akih-san/FUZIX-for-MEZ68K8_RAM-Rev2.1/README.MD

# MEZ68K8_RAM Rev2.1 for FUZIX 0.5

MEZ68K8_RAM Rev2.1は[EMUZ80](https://vintagechips.wordpress.com/2022/03/05/emuz80_reference/)ボード上で動く68008メザニンボードです。

（MEZ68K8_RAM Rev2.1メザニンボード）
<br>

EMUZ80はMicrochip社のPIC18F47Q43/83/84を使用して、Z80を制御するシングルボードコンピュータ
です。また、Z80の代わりにメザニンボードを装着することで、レガシーCPU（6502や、8088、V20、他）
を動かすことが出来ます。<br>
UART, SPI, I2C等の制御をPICで行い、レガシーCPUの外部I/Oとして機能を提供します。
SDカードはSPIを通して実装されています。<br>
PICから、レガシーCPUのメモリ空間にアクセスすることで、レガシーPCのプログラムをロードする
ことが出来るため、ROMは必要なくSRAMでプログラムを動作させることが出来ます。

（EMUZ80、MEZ68K8_RAM、RTCモジュール、SDカードモジュール）
<br>

（動作中のMEZ68K8_RAM Rev2.1）
<br>

MEZ68K8_RAM Rev2.1の[FUZIX](https://www.fuzix.org/)は、platform-[pico68k](https://hackaday.io/project/179200-68000-minimal-homebrew-computer)をベースにポーティングを行いました。

リアルタイムクロックは、platform-[68knano](https://github.com/74hc595/68k-nano)のds3234デバイスの実装を参考にしています。
# FUZIX起動画面
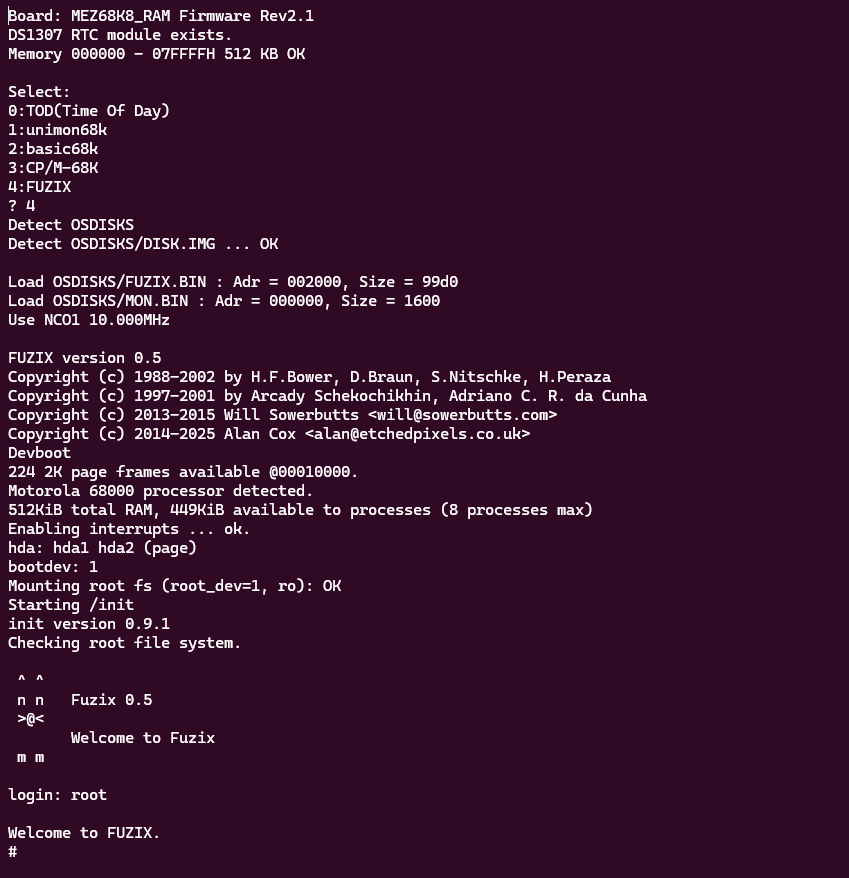
[picture p1: photo/FUZIX起動画面.png]
<br>

MEZ68K8_RAM Rev2.1では、FUZIX以外に、CP/M-68Kや68000用の[Universal Monitor](https://electrelic.com/electrelic/node/1317)をサポートしていますが、詳細については、[MEZ68K8_RAM(Rev1.3)](https://github.com/akih-san/MEZ68K8_RAM)を参照してください。

# [MEZ68K8_RAM(Rev1.3)](https://github.com/akih-san/MEZ68K8_RAM)からの追加変更点

１．IRQ, NMI割り込みのサポート<br>
２．RTC(DS1307)のサポート<br>
３．グルー・ロジック

## １．IRQ, NMI割り込みのサポート
Rev1.3では割り込みなく、最小限の機能を実現していました。Rev2.1では、オートベクターによるレベル５(IRQ)とレベル７(NMI)の割り込みをサポートします。<br>
10msインターバルのＩＲＱ割り込みを発生させています。UARTによるキー入力は、この割り込みでCPUに取り込まれ、バッファリングされます。<br>
CTRL-Qを2回連続して入力することで、NMI割り込みが発生します。FUZIX動作時には、NMI割り込みでモニタ（Universal Monitor）が起動します。<br>
ただし、CP/M-68KはIRQ、NMI割り込みを使っていません。（Rev1.3相当のCP/M-68K）<br>
その他のプログラムではNMI割り込みの表示が出ますが、何もしないで元のプログラムに復帰します。<br>
<br>
## ２．RTC(DS1307)のサポート
I2Cを実装し、DS1307を使ったTiny RTC moduleをサポートします。<br>
Tiny RTC moduleはArduinoで使用可能で、[AliExpress](https://ja.aliexpress.com/?spm=a2g0o.home.logo.1.2fc55c72FX1lyE)から入手
することができます。また、安価な互換品が出回っています。テストでは互換品を使いましたが、特に問題なく使用できました。
SQピン端子は未使用です。SCL、SDA、VCC、GNDの４ピンを使用しています。

(tiny_rtc_modules)<br>
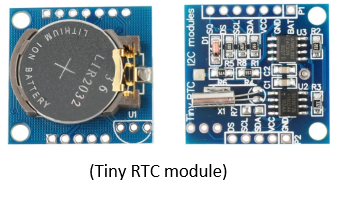
[picture p2: photo/tiny_rtc_modules.png]


(tiny_rtc_modules互換品.png)<br>
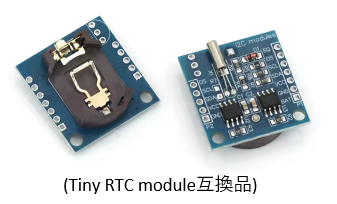
[picture p3: photo/tiny_rtc_modules互換品.png]
<br>

<br>
日時の設定は、ファームウェア起動時のセレクトリスト0番（TOD）で指定します。<br>
RTC(DS1307)モジュールが接続されていない場合、PICのtimer0の10msタイマーを用いて、日時をカウントします。その場合、電源OFFで日時が2025/06/01 00:00:00にリセットされます。<br>
<br>

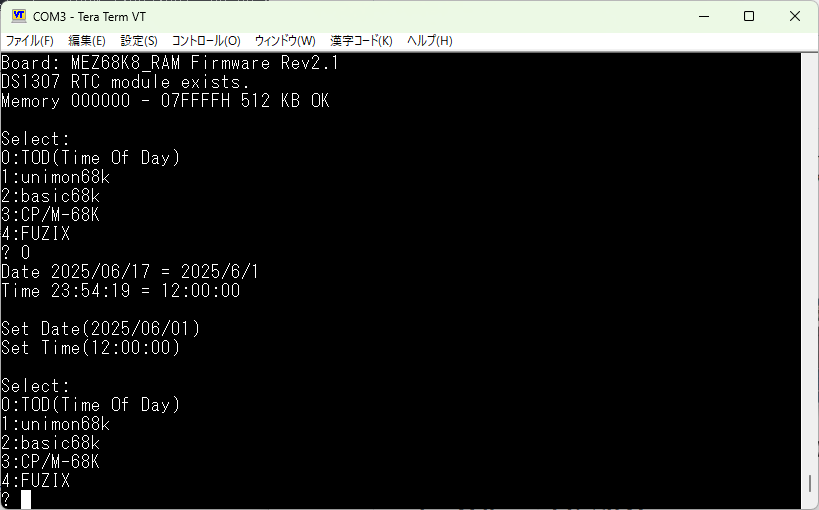
[picture p4: photo/2025-06-17-235411.png]


## ３．グルー・ロジック
SDカードアクセスの一部、割り込み、メモリアクセス関連の外部ロジックをCPLD（ATF16V8B）を使用して1chipにまとめてあります。
使用するために、jedファイルをATF16V8Bに書き込む必要があります。

# FUZIX 0.5終了時の注意点
FUZIXを終了するときには、必ず`shutdown`コマンドを実行してください。`shutdown`コマンドを実行せずに電源をOFFや、リセットSWでリセットした場合、システムファイルが正常終了せずにファイルエラーとなってしまい、次回の立ち上がりで正常に起動しなくなります。<br>
システムファイルのリカバリーで回復しますが、必ず回復するかどうか分かりません。最悪DISK.IMGファイルをコピーし直す必要があります。<br>

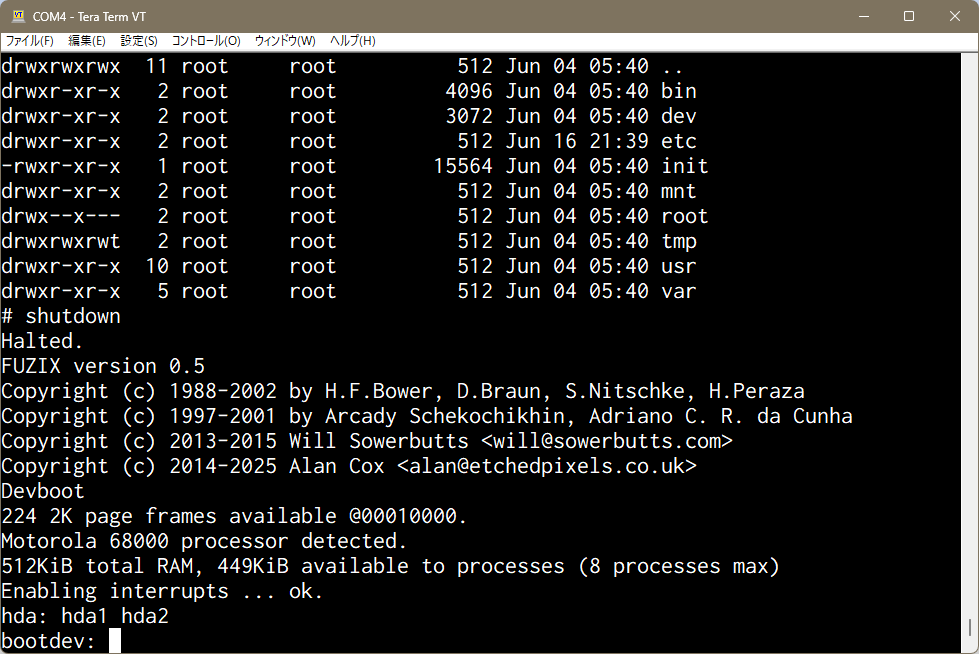
[picture p5: photo/shutdown.png]
<br>
<br>
<br>
`shutdown`し`halt`状態になると、bootデバイスの入力状態に戻ります。しかし、理由は不明ですが、ここでbootデバイスを入力しても再起動できません。再起動するには、電源OFF/ONか、リセットSWを押す必要があります。<br>
<br>

# ファームウェアの書き込み
## 1. PIC18F47Q43/Q84/Q83
PICへの書き込みツールを用いて、ヘキサファイルを書き込みます。<br>
<br>
- PIC18F47Q43 - Q43Rev2.1.hex
- PIC18F47Q84 - Q84Rev2.1.hex
- PIC18F47Q83 - Q83Rev2.1.hex
<br>
＜注意点＞<br>
EMUZ80ボードから、メザニンボード（MEZ68K8_RAM Rev2.1）を外した状態でPICへの書き込みを行います。
メザニンボードを装着しての書き込みは、かなりの高確率で失敗します。もしくは、PICに書き込めるライターを使用し、直接PICへ書き込みを行います。<br>
<br>
＜使用確認した書き込みツール＞<br>
<br>
- snap(マイクロチップ社の書き込みツール)<br>

  - [snap](https://www.microchip.com/en-us/development-tool/PG164100)

<br>
- PICkit3（または互換ツール）<br><br>
  PICkitminus書き込みソフトを用いて、書き込むことが出来ます。以下で入手できます。<br>

  - [PICkitminus](https://github.com/jaka-fi/PICkitminus)

## ２．CPLDへの書き込み

　　CPLDには、ROMライタを使用してG16V8B/MEZ68K8_RAM2.1.jedファイルを書込みます。<br>
　　使用したのは、XGecu Programmer Model TL866Ⅱ PLUSです。<br>
　　少し古いですが、問題なく書き込みが出来ました。XGecu Official Siteは[こちら](https://xgecu.myshopify.com/)<br>
　　ソフトウェアのダウンロードは[こちら](http://www.xgecu.com/en/Download.html?refreshed=1750208080997)<br>

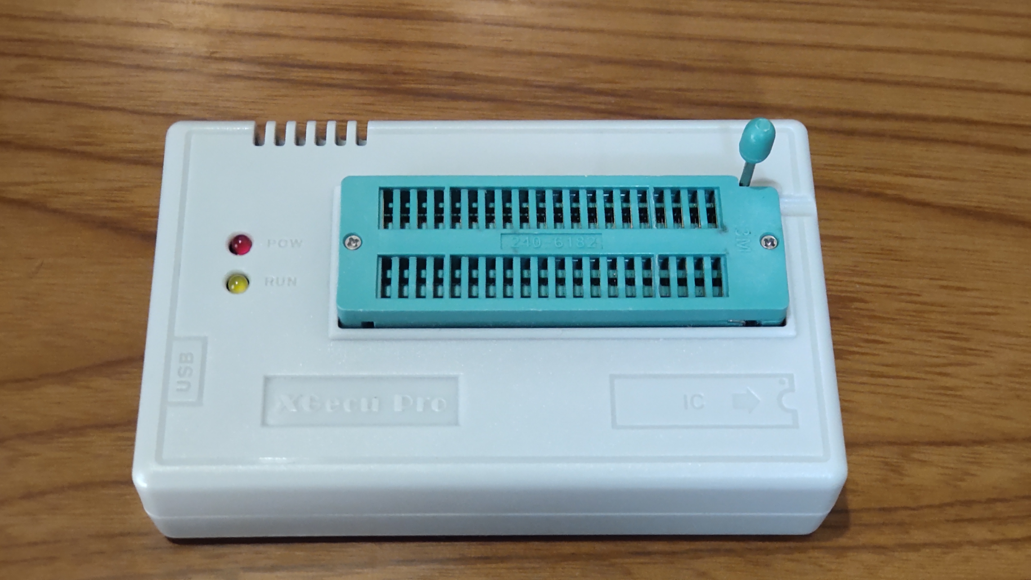
[picture p6: photo/ROM_WRITER.JPG]
   <br>
（今回使用したROMライタ）

## ３．μＳＤカードの作成
μSDカードはFAT32を使用しています。4G～16GBまでのＳＤカードで動作確認を行いました。DISKSフォルダ内の以下のフォルダとファイルを、FAT32でフォーマットされた
μSDカードにコピーします。<br>
<br>
　・CPMDISKS（CP/M-68K関連のフォルダ）<br>
　・OSDISKS	（FUZIX関連のフォルダ）<br>

　　（注意）フォルダ内に、圧縮されたDISK.zipファイルがあります。<br>
　　　　　　Gitのファイル容量制限でFUZIXのディスクイメージファイルを圧縮してあります。<br>
　　　　　　解凍したDISK.IMGファイルをコピーします。<br>

　・BASIC68K.BIN	（スタンドアロン版BASIC）<br>
　・UMON_68K.BIN	（ユニバーサルモニタ）

# 図面、部品表、PICピンアサイン、Gerberデータ
  - [図面](https://github.com/akih-san/FUZIX-for-MEZ68K8_RAM-Rev2.1/blob/main/pdf/MEZ68K8_RAM_R2.1%E5%9B%B3%E9%9D%A2.pdf)
  - [部品表](https://github.com/akih-san/FUZIX-for-MEZ68K8_RAM-Rev2.1/blob/main/pdf/MEZ68K8_RAM_R2.1%E9%83%A8%E5%93%81%E8%A1%A8.pdf)
  - [PICピンアサイン](https://github.com/akih-san/FUZIX-for-MEZ68K8_RAM-Rev2.1/blob/main/pdf/MEZ68K8_RAM%20v2.1%EF%BC%88PIC%E3%83%94%E3%83%B3%E3%82%A2%E3%82%B5%E3%82%A4%E3%83%B3%EF%BC%89.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)
  - [Gerberデータ](https://github.com/akih-san/FUZIX-for-MEZ68K8_RAM-Rev2.1/tree/main/MEZ68K8_RAM_R2.1_gerber)

# ソースコードからFUZIX 05をビルドする
[FUZIX](https://www.fuzix.org/)の移植をLinuxで行います。Windows10/11であれば、WSLを使えば問題なく移植できる？のではないでしょうか。
私の場合は、raspberrypi 5を開発環境として使用しました。

## 1. m68k-elf-gcc
68000版の移植にはm68k-elf-gccが必要です。私は[ここ](https://github.com/andwn/marsdev/releases)から入手しました。<br>
GitHubからクローンして：
 - `git clone https://github.com/andwn/marsdev`
 - `cd marsdev`

makeに、いくつかパッケージが必要となりますので、無ければインストールする必要があります。<br>
　`ubuntu: build-essential texinfo wget`<br>
 - `apt install build-essential texinfo wget`<br>
 - `make m68k-toolchain`<br>
　　（PCのCPUパワーに依存しますが、makeに少々時間がかかります。）<br>
 - `sudo make install`<br>
　　デフォルトだと/opt/toolchains/marsにm68k-elf-gccの環境が作られます。<br>
　　PATHを通せば、使用可能となります。.bashrc等に設定すればOK<br>
 - `export PATH="$PATH:/opt/toolchains/mars/m68k-elf/bin"`<br>
<br>
以下のようにバージョンが表示されればＯＫ<br>

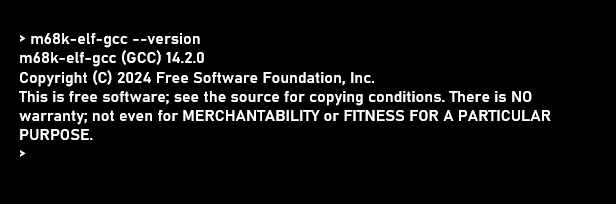
[picture p7: photo/gcc_ver.png]


<br>
（日本語ファイルREADME-ja.mdがありますので、参照してください）<br>

## 2. FUZIX 0.5をgit
[FUZIXをビルドしてみよう【0.4版】](https://cwaweb.bai.ne.jp/~ohishi/zakki/buildFUZIX.htm)を参考にしました。分かりやすく解説されています。<br>
ビルドに必要なパッケージも解説されていますので、足りないものはインストールが必要です。<br>
　・`GCC (C/C++)`<br>
　・`byacc`<br>
　・`flex`<br>
　・`boost-devel (libboost-dev)`<br>
　・`makeinfo (texinfo)`<br>
　・`git`<br>
　・`zlib (zlib1g-dev)`<br>
　　　byaccについては次の後処理が必要とのこと。<br>
　・`sudo update-alternatives --set yacc /usr/bin/byacc`<br>
<br>
準備ができたら、FUZIXをgitします。<br>
 - `git clone https://github.com/EtchedPixels/FUZIX.git`<br>
<br>

## 3. platformにmez68k-ramを追加する
(カレントディレクトリにFUZIXとFUZIX-for-MEZ68K8_RAM-Rev2.1をgitしていると仮定しています。）<br>
FUZIX/Kernrl/platformフォルダの下にplatform-mez68k-ramフォルダをコピーします。<br>
 - `cp -r ~/FUZIX-for-MEZ68K8_RAM-Rev2.1/platform-mez68k-ram ~/FUZIX/Kernrl/platform`<br>
<br>

## 4. Makefileを編集し、mez68k-ramを指定する
次に、~/FUZIX/Makefileを編集し、ターゲットにmez68k-ramを指定します。<br>
 - `TARGET ?= zrc　　-->  TARGET ?= mez68k-ram`<br>

## 5. FUZIXフォルダ下でMakeする
 - `$ cd FUZIX`<br>
 - `~/FUZIX$ make`　　（少々時間がかかります。）<br>
 - `~/FUZIX$ make diskimage`<br>

## 6. 作成されるファイル
 - FUZIX/Images/mez68k-ramフォルダの下に、DISK.IMG<br>
 - FUZIX/Kernelフォルダの下に、FUZIX.BIN<br>
 - FUZIX/Kernrl/platform/platform-mez68k-ramフォルダの下に、MON.BIN<br>
<br>

# 余談
/usr/binにviとvileが入ってますが、正常に動きません。何か設定が必要なのかもしれませんが、よく分からないです。
viクローンとして、FUZIX/Applications/leveeがありますが、makeで収録しません。個別にmakeしたところ、
m68k-elf-gcc Ver.14.2ではエラーでmake出来ませんでした。戻り値を返さないルートがある関数があってはじかれているようです。
しかし、Ver.6.3の[m68k-elf-gcc](https://github.com/kentosama/m68k-elf-gcc)でmakeしたところワーニングにはなりますが、
バイナリが作成されました。動かしてみると、levee-ansiはTera Term上で動くようです。ま、不具合があるかもしれませんが、
バイナリをアップしておくことにします。
DISK.IMGへの組み込みは、[PC版UCP](https://www.rad51.net/jeans/index.php?itemid=957)を使うと便利です。
<br>
<br>

# その他のツール
・FWのソースのコンパイルは、マイクロチップ社の「MPLAB® X Integrated Development Environment (IDE)」を使っています。<br>
　[MPLAB X IDE v6.25](https://www.microchip.com/en-us/tools-resources/develop/mplab-x-ide)<br>
　コンパイラは、XC8を使用しています。<br>
<br>
・universal moniter 68000、及びEnhanced 68k BASICは、<br>
　[Macro Assembler AS V1.42](http://john.ccac.rwth-aachen.de:8000/as/) 
を使用してバイナリを作成しています。<br>
<br>
・FatFsはR0.15を使用しています。<br>
　＜FatFs - Generic FAT Filesystem Module＞<br>
　http://elm-chan.org/fsw/ff/00index_e.html<br>
<br>

# 参考
＜EMUZ80＞<br>
EUMZ80はZ80CPUとPIC18F47Q43のDIP40ピンIC2つで構成されるシンプルなコンピュータです。<br>
（電脳伝説 - EMUZ80が完成）  <br>
https://vintagechips.wordpress.com/2022/03/05/emuz80_reference  <br>
<br>
＜SuperMEZ80＞<br>
SuperMEZ80は、EMUZ80にSRAMを追加しZ80をノーウェイトで動かすことができます。<br>
<br>
＜SuperMEZ80＞<br>
https://github.com/satoshiokue/SuperMEZ80<br>
<br>
＜＠hanyazouさんのソース＞<br>
https://github.com/hanyazou/SuperMEZ80/tree/mez80ram-cpm<br>
<br>
＜@electrelicさんのユニバーサルモニタ＞<br>
https://electrelic.com/electrelic/node/1317<br>

＜オレンジピコショップ＞  <br>
オレンジピコさんでEMUZ80、その他メザニンボードの購入できます。<br>
<br>
https://store.shopping.yahoo.co.jp/orangepicoshop/pico-a-051.html<br>
https://store.shopping.yahoo.co.jp/orangepicoshop/pico-a-061.html<br>
https://store.shopping.yahoo.co.jp/orangepicoshop/pico-a-062.html<br>
https://store.shopping.yahoo.co.jp/orangepicoshop/pico-a-079.html<br>
https://store.shopping.yahoo.co.jp/orangepicoshop/pico-a-087.html<br>
