akih-san/FUZIX-for-MEZ68K8_RAM-Rev2.1/photo/FUZIX opening.png

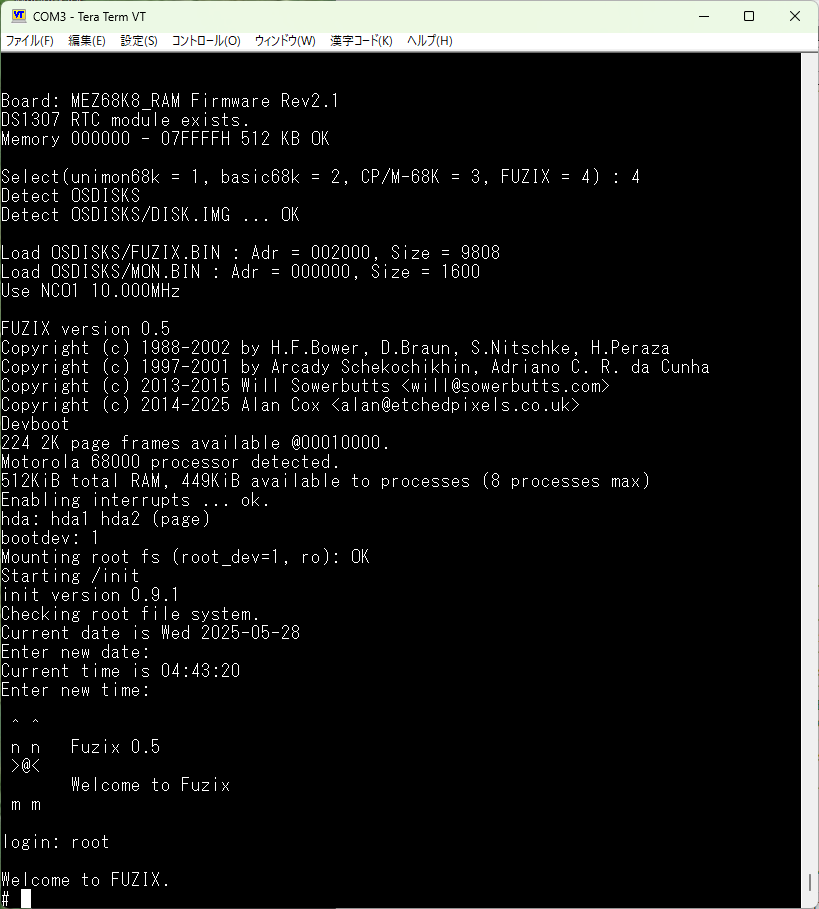
photo/FUZIX opening.png
