akih-san/FUZIX-for-MEZ68K8_RAM-Rev2.1/photo/mez68k8_ram view.png

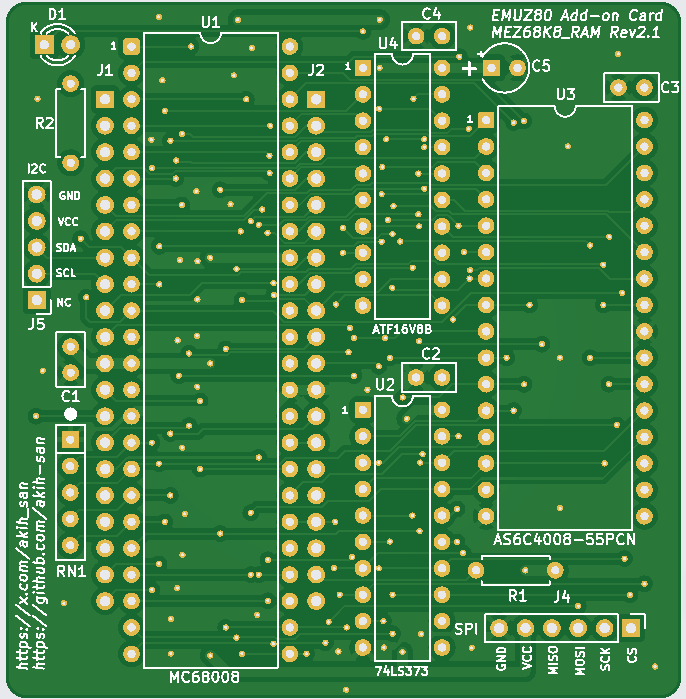
photo/mez68k8_ram view.png
