akih-san/FUZIX-for-MEZ68K8_RAM-Rev2.1/pdf/MEZ68K8_RAM_R2.1部品表.pdf

＜MEZ68K8_RAM Rev2.1部品表＞

No. | 部品番号 | 数 | 値、品番 | 名称
1 | C1,C2,C3,C4 | 4 | 0.1μF | 積層セラミックコンデンサー　D5.0mm W2.5mm P2.50mm
2 | C5 | 1 | 47μF | 電解コンデンサー　10V以上
3 | D1 | 1 | LED | 発光ダイオード　順電圧 2 - 2.2V
4 | J1,J2 | 2 | 20ピンソケット | EMUZ80接続用2.54mmピッチ
5 | J4 | 1 | SPI | μSDカード用 1x06 2.54mmピッチピンヘッダ
6 | J5 | 1 | I2C | RTC DS1307用1x04 2.54mmピッチピンヘッダ（Arudinoピン配置）
7 | R1 | 1 | 4.7KΩ 1/4W | カーボン抵抗(炭素皮膜抵抗)
8 | R2 | 1 | 1.5KΩ 1/4W | カーボン抵抗(炭素皮膜抵抗)
9 | RN1 | 1 | 4素子 10kΩ | 集合抵抗 4素子
10 | U1 | 1 | CPU | MC68008 (DIP48)
11 | U2 | 1 | 74LS373 | 3ステート出力、8bit Dラッチ(DIP20)
12 | U3 | 1 | AS6C4008-55PCN | 512kw×8bit SRAM（DIP32)
13 | U4 | 1 | ATF16V8B | Atmel CPLD (DIP20)
