akih-san/FUZIX-for-MEZ68K8_RAM-Rev2.1/(list of files, cad)

Other CAD files:
os/m68kbios.obj
