akih-san/FUZIX-for-MEZ68K8_RAM-Rev2.1/pdf/MEZ68K8_RAM_R2.1図面.pdf

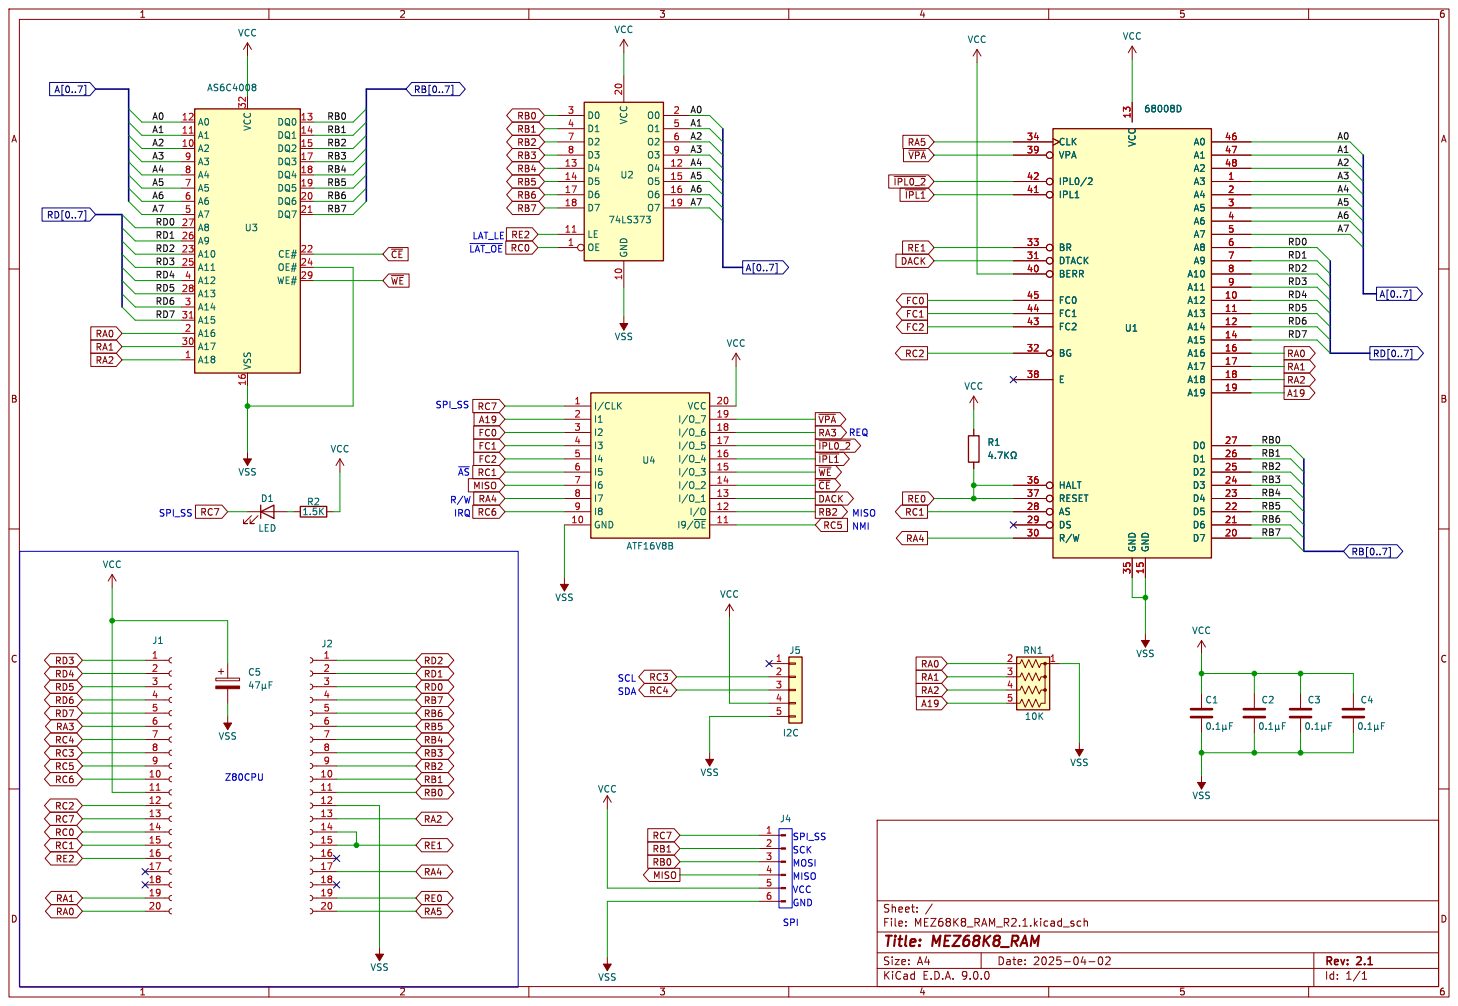
[picture p10: page 1]
