akih-san/FUZIX-for-MEZ68K8_RAM-Rev2.1/unimon_irq/unimon_68k_irq.asm

;;;
;;; Universal Monitor 68000
;;;   Copyright (C) 2021 Haruo Asano
;;;

	page 0
	CPU	68000
	SUPMODE	ON

;;;
;;; Memory
;;;

VECT_T:	EQU	$00000000
PROG_B:	EQU	$00000400
SHAD_M: EQU	$00000100		;PIC <-> 68008 Shared Memory

BUFLEN:	EQU	24		; Input buffer size
VECSIZ:	EQU	256		; Number of vectors to be initialized

;;;
;;; Options
;;;

USE_IDENT = 0			; MPU Identification
MPU_SPEC = 0			; MPU Spec. (Effective when USE_IDENT=0) 0:MC68000/8 1:MC68010

USE_REGCMD = 1			; R(egister) command and related functions
USE_SFDECODE = 0		; Decode Stack Frame


	IFNDEF USE_SFDECODE
USE_SFDECODE = 1
	ENDIF

;;;
;;; Common header file
;;;

;;; Constants
CR:	EQU	$0D
LF:	EQU	$0A
BS:	EQU	$08
DEL:	EQU	$7F

;;; Functions
low	function	x,(x & 255)
high	function	x,(x >> 8)

;;;;;;;;;;;;;;;;;;;;;;;;;;;;;;;;;;
;
; define Vecter table
;
;;;;;;;;;;;;;;;;;;;;;;;;;;;;;;;;;;

	ORG	VECT_T

INIVEC:
	;; 0-7
	DC.L	STACK		; Reset: Initial SSP
	DC.L	CSTART		; Reset: Initial PC

	DC.L	BUSERR_H	; Bus Error
	DC.L	ADDERR_H	; Address Error

	DC.L	ILLINS_H	; Illegal Instruction
	DC.L	ZERDIV_H	; Zero Divide
	DC.L	CHK_H		; CHK Instruction
	DC.L	TRAPV_H		; TRAPV Instruction

	;; 8-15
	DC.L	PRIV_H		; Privilege Violation
	DC.L	TRACE_H		; Trace
	DC.L	L1010_H		; Line 1010 Emulator
	DC.L	L1111_H		; Line 1111 Emulator

	DC.L	DUMMY_H		; (Unassigned, reserved)
	DC.L	DUMMY_H		; (Unassigned, reserved)
	DC.L	FORMAT_H	; Format Error (MC68010)
	DC.L	DUMMY_H		; (Unassigned, reserved)

	;; 16-23
	DC.L	DUMMY_H		; (Unassigned, reserved)
	DC.L	DUMMY_H		; (Unassigned, reserved)
	DC.L	DUMMY_H		; (Unassigned, reserved)
	DC.L	DUMMY_H		; (Unassigned, reserved)

	DC.L	DUMMY_H		; (Unassigned, reserved)
	DC.L	DUMMY_H		; (Unassigned, reserved)
	DC.L	DUMMY_H		; (Unassigned, reserved)
	DC.L	DUMMY_H		; (Unassigned, reserved)

	;; 24-31
	DC.L	DUMMY_H		; Spurious Interrupt
	DC.L	DUMMY_H		; Level 1 Interrupt Autovector
	DC.L	DUMMY_H		; Level 2 Interrupt Autovector
	DC.L	DUMMY_H		; Level 3 Interrupt Autovector

	DC.L	DUMMY_H		; Level 4 Interrupt Autovector
	DC.L	IRQ5_H		; Level 5 Interrupt Autovector
	DC.L	DUMMY_H		; Level 6 Interrupt Autovector
	DC.L	NMI_H		; Level 7 Interrupt Autovector

	;; 32-39
	DC.L	TRAP0_H		; TRAP Instruction Vector #0
	DC.L	TRAP1_H		; TRAP Instruction Vector #1
	DC.L	TRAP2_H		; TRAP Instruction Vector #2
	DC.L	TRAP3_H		; TRAP Instruction Vector #3

	DC.L	TRAP4_H		; TRAP Instruction Vector #4
	DC.L	TRAP5_H		; TRAP Instruction Vector #5
	DC.L	TRAP6_H		; TRAP Instruction Vector #6
	DC.L	TRAP7_H		; TRAP Instruction Vector #7

	;; 40-47
	DC.L	TRAP8_H		; TRAP Instruction Vector #8
	DC.L	TRAP9_H		; TRAP Instruction Vector #9
	DC.L	TRAP10_H	; TRAP Instruction Vector #10
	DC.L	TRAP11_H	; TRAP Instruction Vector #11

	DC.L	TRAP12_H	; TRAP Instruction Vector #12
	DC.L	TRAP13_H	; TRAP Instruction Vector #13
	DC.L	TRAP14_H	; TRAP Instruction Vector #14
	DC.L	TRAP15_H	; TRAP Instruction Vector #15

INIVECE:
;;;;;;;;;;;;;;;;;;;;;;;;;;;;;;;;;;
;
; define shared memory area
;
;;;;;;;;;;;;;;;;;;;;;;;;;;;;;;;;;;
	ORG	SHAD_M

;----------------------------------------------------------------------------------
; request command to PIC
;----------------------------------------------------------------------------------
REQ_CONIN:	equ	1		; return char in UNI_CHR
REQ_CONOUT	equ	2		; UNI_CHR = output char
REQ_CONST:	equ	3		; return status in UNI_CHR( 0: no key, 1 : key exist )
REQ_STROUT	equ	4		; string output to console
					; UNI_CHR or CBI_CHR = string size.
					; STR_addr or data_dma = string address
REQ_CONIN1:	equ	9		; return char,(null char is no key)
REQ_CONOUT1:	equ	10		; return status,(0:output OK, 1:console busy)
REQ_STRIN	equ	11
REQ_CLR_IRQ:	equ	12		; clear IRQ interrupt request

PIC_REQ:	equ	$80000		;A19 = 1

;			   ; offset:
UREQ_COM:	DS.B	1	; 0: monitor CONIN/CONOUT request command
UNI_CHR:	DS.B	1	; 1: charcter (CONIN/CONOUT) or number of strings
STR_addr	DS.L	1	; 2: string address
;--------------------------------------------------------------------------------
CREQ_COM:	DS.B	1	; 6: PIC function CONIN/CONOUT request command
CBI_CHR:	DS.B	1	; 7: charcter or return status
disk_drive:	DS.B	1	; 8
		DS.B	1	; 9
disk_track:	DS.W	1	; A
disk_sector:	DS.W	1	; C
data_dma:	DS.L	1	; E,F,10,11

crd_cnt:	ds.b	1
crd_rp:		ds.b	1
crd_wp:		ds.b	1

req_e:

	org	(req_e+$80) & $ff80

con_size:	equ	128
contmp_buf:	ds.b	con_size	; tmp string buffer
crd_buf:	ds.b	con_size	; console input buffer

;;;;;;;;;;;;;;;;;;;;;;;;;;;;;;;;;;
;
; unimon program
;
;;;;;;;;;;;;;;;;;;;;;;;;;;;;;;;;;;
	ORG	PROG_B

CSTART:
	BSR	INIT

	IF INIVEC <> $00000000
	MOVE.L	#VECSIZ*4,D0
	ELSE
	MOVE.L	#DAT_E,D0
	ENDIF

	MOVE.L	D0,DSADDR
	MOVE.L	D0,GADDR
	MOVE.L	D0,SADDR
	MOVE.B	#'S',HEXMOD
	MOVE.B	#MPU_SPEC,PSPEC

	IF INIVEC <> $00000000
	;; Initialize vector area
	MOVE.L	#INIVEC,A0
	MOVE.L	#$00000000,A1
	MOVE	#VECSIZ,D1
INI0:
	MOVE.L	(A0)+,(A1)+
	SUBQ	#1,D1
	BEQ	INI2
	CMP.L	INIVECE,A0
	BNE	INI0
	MOVE.L	#DUMMY_H,D0
INI1:
	MOVE.L	D0,(A1)+
	SUBQ.L	#1,D1
	BNE	INI1
INI2:
	ENDIF

	IF USE_REGCMD

	;; Initialize register save area
	LEA	REG_B,A0
	MOVE	#(REG_E-REG_B)-1,D0
INIR0:
	CLR.B	(A0)+
	DBF	D0,INIR0
	MOVE.L	#STACK,REGSSP
	MOVE.L	#DAT_E,REGPC
	MOVE.L	#USTACK,REGA7
	
	ENDIF

	;; Opening message
	LEA	OPNMSG,A0
	BSR	STROUT

	IF USE_IDENT

	LEA	IM000,A0
	SAVE
	CPU	68010
ID0:	MOVEC	VBR,D0		; Try MC68010 instruction
	RESTORE

	SAVE
	CPU	68020
ID1:	CALLM	#0,MDESC	; Try MC68020 instruction
	RESTORE
	LEA	IM020,A0
	MOVE.B	#2,PSPEC
	BRA	ID9

ID2:
	SAVE
	CPU	68030
ID3:	MOVEC	CACR,D0		; Try MC68020 instruction (since MC68020 already eliminated, this checks MC68030)
	RESTORE
	LEA	IM030,A0
	MOVE.B	#3,PSPEC

ID9:
	BSR	STROUT

	ENDIF

WSTART:

	; set interrupt level 4

	lea	STACK, a7
	move.w #$2400,sr

	LEA	PROMPT,A0
	BSR	STROUT
	BSR	GETLIN
	LEA	INBUF,A0
	BSR	SKIPSP
	MOVE.B	(A0),D0
	BSR	UPPER
	TST.B	D0
	BEQ	WSTART

	CMP.B	#'D',D0
	BEQ	DUMP
	CMP.B	#'G',D0
	BEQ	GO
	CMP.B	#'S',D0
	BEQ	SETM

	CMP.B	#'L',D0
	BEQ	LOADH
	CMP.B	#'P',D0
	BEQ	SAVEH

	IF USE_REGCMD
	CMP.B	#'R',D0
	BEQ	REG
	ENDIF

ERR:
	LEA	ERRMSG,A0
	BSR	STROUT
	BRA	WSTART

;;;
;;; Dump memory
;;;

DUMP:
	ADDQ	#1,A0
	BSR	SKIPSP
	BSR	RDHEX		; 1st arg.
	TST	D2
	BNE	DP0
	;; No arg.
	BSR	SKIPSP
	TST.B	(A0)
	BNE	ERR
	MOVE.L	DSADDR,D0
	ADD.L	#128,D0
	MOVE.L	D0,DEADDR
	BRA	DPM

	;; 1st arg. found
DP0:
	MOVE.L	D1,DSADDR
	BSR	SKIPSP
	CMP.B	#',',(A0)
	BEQ	DP1
	TST.B	(A0)
	BNE	ERR
	;; No 2nd arg.
	ADD.L	#128,D1
	MOVE.L	D1,DEADDR
	BRA	DPM

DP1:
	ADDQ	#1,A0
	BSR	SKIPSP
	BSR	RDHEX
	BSR	SKIPSP
	TST	D2
	BEQ	ERR
	TST.B	(A0)
	BNE	ERR
	ADDQ.L	#1,D1
	MOVE.L	D1,DEADDR

	;; DUMP main
DPM:
	MOVE.L	DSADDR,D0
	AND.B	#$F0,D0
	MOVE.L	D0,A1
	CLR	D2		; DSTATE
DPM0:
	BSR	DPL
	BSR	con_st
	TST.B	D0
	BNE	DPM1
	CMP	#2,D2		; DSTATE
	BCS	DPM0
	MOVE.L	DEADDR,DSADDR
	BRA	WSTART
DPM1:
	MOVE.L	A1,DSADDR
	BSR	con_in
	BRA	WSTART

	;; DUMP line
DPL:
	MOVE.L	A1,D0
	BSR	HEXOUT8
	LEA	DSEP0,A0
	BSR	STROUT
	LEA	INBUF,A2
	MOVE	#15,D3
DPL0:
	BSR	DPB
	DBF	D3,DPL0

	LEA	DSEP1,A0
	BSR	STROUT

	LEA	INBUF,A2
	MOVE	#15,D3
DPL1:
	MOVE.B	(A2)+,D0
	CMP.B	#' ',D0
	BCS	DPL2
	CMP.B	#$7F,D0
	BCC	DPL2
	BSR	con_out
	BRA	DPL3
DPL2:
	MOVE.B	#'.',D0
	BSR	con_out
DPL3:
	DBF	D3,DPL1
	BRA	CRLF

	;; DUMP byte
DPB:
	MOVE.B	#' ',D0
	BSR	con_out
	TST	D2		; DSTATE
	BNE	DPB2
	;; Dump state 0
	CMP.L	DSADDR,A1
	BEQ	DPB1
	;; Still 0 or 2
DPB0:
	MOVE.B	#' ',D0
	BSR	con_out
	BSR	con_out
	MOVE.B	D0,(A2)+
	ADDQ	#1,A1
	RTS
	;; Found start address
DPB1:
	MOVE	#1,D2		; DSTATE
DPB2:
	CMP	#1,D2		; DSTATE
	BNE	DPB0
	;; Dump state 1
	MOVE.B	(A1)+,D0
	MOVE.B	D0,(A2)+
	BSR	HEXOUT2
	CMP.L	DEADDR,A1
	BEQ	DPB3
	RTS
	;; Found end address
DPB3:	
	MOVE	#2,D2		; DSTATE
	RTS

;;;
;;; GO address
;;;

GO:
	ADDQ	#1,A0
	BSR	SKIPSP
	BSR	RDHEX
	TST.B	(A0)
	BNE	ERR
	TST	D2
	BEQ	G0

	IF USE_REGCMD

	MOVE.L	D1,REGPC
G0:
	MOVE.L	REGSSP,D0
	AND.L	#$FFFFFFFE,D0
	MOVE.L	D0,A7

	TST.B	PSPEC
	BEQ	G1

	;; MC68010 only
	SAVE
	CPU	68010

	MOVE	#$0000,-(A7)	; Format / Dummy (Vector Offset)

	MOVE.L	REGVBR,D0
	AND.L	#$FFFFFFFE,D0
	MOVEC	D0,VBR		; Be careful!
	MOVE.B	REGSFC,D0
	MOVEC	D0,SFC
	MOVE.B	REGDFC,D0
	MOVEC	D0,DFC
	
	RESTORE
G1:
	MOVE.L	REGPC,-(A7)
	MOVE	REGSR,-(A7)

	MOVE.L	REGA7,A0
	MOVE	A0,USP

	MOVEM.L	REGD0,D0-D7/A0-A6

	RTE
	
	ELSE
	
	MOVE.L	D1,GADDR
G0:
	MOVE.L	GADDR,A0
	JMP	(A0)

	ENDIF

;;;
;;; SET memory
;;;

SETM:
	ADDQ	#1,A0
	BSR	SKIPSP
	BSR	RDHEX
	BSR	SKIPSP
	TST.B	(A0)
	BNE	ERR
	MOVE.L	D1,A1
	TST	D2
	BNE	SM0
	MOVE.L	SADDR,A1
SM0:
SM1:
	MOVE.L	A1,D0
	BSR	HEXOUT8
	LEA	DSEP1,A0
	BSR	STROUT
	MOVE.B	(A1),D0
	BSR	HEXOUT2
	MOVE.B	#' ',D0
	BSR	con_out
	BSR	GETLIN
	LEA	INBUF,A0
	BSR	SKIPSP
	MOVE.B	(A0),D0
	BNE	SM2
	;; Empty (Increment address)
	ADDQ	#1,A1
	MOVE.L	A1,SADDR
	BRA	SM1
SM2:
	CMP.B	#'-',D0
	BNE	SM3
	;; '-' (Decrement address)
	SUBQ	#1,A1
	MOVE.L	A1,SADDR
	BRA	SM1
SM3:
	CMP.B	#'.',D0
	BNE	SM4
	;; '.' (Quit)
	MOVE.L	A1,SADDR
	BRA	WSTART
SM4:
	BSR	RDHEX
	TST	D2
	BEQ	ERR
	MOVE.B	D1,(A1)+
	MOVE.L	A1,SADDR
	BRA	SM1

;;;
;;; LOAD HEX file
;;;

LOADH:
	ADDQ	#1,A0
	BSR	SKIPSP
	BSR	RDHEX
	BSR	SKIPSP
	TST.B	(A0)
	BNE	ERR

	TST	D2
	BNE	LH0

	CLR.L	D1		; Offset
LH0:
	BSR	con_in
	BSR	UPPER
	CMP.B	#'S',D0
	BEQ	LHS0
LH1:
	CMP.B	#':',D0
	BEQ	LHI0
	;; Skip to EOL
LH2:
	CMP.B	#CR,D0
	BEQ	LH0
	CMP.B	#LF,D0
	BEQ	LH0
LH3:
	BSR	con_in
	BRA	LH2

	;; Intel HEX
LHI0:
	BSR	HEXIN
	CLR	D2
	MOVE.B	D0,D2		; Length
	MOVE.B	D0,D3		; Checksum

	BSR	HEXIN
	CLR.L	D4
	MOVE.B	D0,D4		; Address H
	ADD.B	D0,D3		; Checksum

	BSR	HEXIN
	LSL	#8,D4
	MOVE.B	D0,D4		; Address L
	ADD.B	D0,D3		; Checksum

	;; Add offset
	ADD.L	D1,D4
	MOVE.L	D4,A1

	BSR	HEXIN
	MOVE.B	D0,RECTYP
	ADD.B	D0,D3		; Checksum

	TST	D2
	BEQ	LHI3
	SUBQ	#1,D2
LHI1:
	BSR	HEXIN
	ADD.B	D0,D3		; Checksum

	TST.B	RECTYP
	BNE	LHI2

	MOVE.B	D0,(A1)+
LHI2:
	DBF	D2,LHI1
LHI3:
	BSR	HEXIN
	ADD.B	D0,D3		; Checksum
	BNE	LHIE		; Checksum error
	TST.B	RECTYP
	BEQ	LH3
	BRA	WSTART
LHIE:
	LEA	IHEMSG,A0
	BSR	STROUT
	BRA	WSTART

	;; Motorola S record
LHS0:
	BSR	con_in
	MOVE.B	D0,RECTYP

	BSR	HEXIN
	CLR	D2
	MOVE.B	D0,D2		; Length+3
	MOVE.B	D0,D3		; Checksum

	BSR	HEXIN
	CLR.L	D4
	MOVE.B	D0,D4		; Address H
	ADD.B	D0,D3		; Checksum

	BSR	HEXIN
	LSL.L	#8,D4
	MOVE.B	D0,D4		; Address L
	ADD.B	D0,D3		; Checksum

	;; Add offset
	ADD.L	D1,D4
	MOVE.L	D4,A1

	SUBQ	#3,D2
	BEQ	LHS3
	SUBQ	#1,D2
LHS1:
	BSR	HEXIN
	ADD.B	D0,D3		; Checksum

	CMP.B	#'1',RECTYP
	BNE	LHS2

	MOVE.B	D0,(A1)+
LHS2:
	DBF	D2,LHS1
LHS3:
	BSR	HEXIN
	ADD.B	D0,D3		; Checksum
	CMP.B	#$FF,D3
	BNE	LHSE		; Checksum error

	CMP.B	#'9',RECTYP
	BEQ	LHSR
	BRA	LH3
LHSE:
	LEA	SHEMSG,A0
	BSR	STROUT
LHSR:
	BRA	WSTART

;;;
;;;  SAVE HEX file
;;;

SAVEH:
	ADDQ	#1,A0
	MOVE.B	(A0),D0
	BSR	UPPER
	CMP.B	#'I',D0
	BEQ	SH0
	CMP.B	#'S',D0
	BNE	SH1
SH0:
	ADDQ	#1,A0
	MOVE.B	D0,HEXMOD
SH1:
	BSR	SKIPSP
	BSR	RDHEX
	TST	D2
	BEQ	ERR
	MOVE.L	D1,A1		; Start address
	BSR	SKIPSP
	CMP.B	#',',(A0)+
	BNE	ERR
	BSR	SKIPSP
	BSR	RDHEX		; D1 = End address
	TST	D2
	BEQ	ERR
	BSR	SKIPSP
	TST.B	(A0)
	BNE	ERR

SH2:
	SUB.L	A1,D1
	ADDQ	#1,D1		; D1 = Length
SH3:
	BSR	SHL
	TST.L	D1
	BNE	SH3

	CMP.B	#'I',HEXMOD
	BNE	SH4
	;; End record for Intel HEX
	LEA	IHEXER,A0
	BSR	STROUT
	BRA	WSTART
	;; End record for Motorola S record
SH4:
	LEA	SRECER,A0
	BSR	STROUT
	BRA	WSTART

SHL:
	MOVEQ.L	#16,D2
	CMP.L	D2,D1
	BCC	SHL0
	MOVE.L	D1,D2
SHL0:
	SUB.L	D2,D1		; D1 = remain

	CMP.B	#'I',HEXMOD
	BNE	SHLS

	;; Intel HEX
	MOVE.B	#':',D0
	BSR	con_out

	MOVE.B	D2,D0
	MOVE.B	D2,D3		; Checksum
	BSR	HEXOUT2		; Length

	MOVE.L	A1,D0
	LSR	#8,D0
	ADD.B	D0,D3		; Checksum
	BSR	HEXOUT2		; Address H

	MOVE.L	A1,D0
	ADD.B	D0,D3		; Checksum
	BSR	HEXOUT2		; Address L

	CLR.B	D0
	BSR	HEXOUT2		; Record type

	SUBQ	#1,D2
SHLI0:
	MOVE.B	(A1)+,D0
	ADD.B	D0,D3		; Checksum
	BSR	HEXOUT2

	DBF	D2,SHLI0

	MOVE.B	D3,D0
	NEG.B	D0
	BSR	HEXOUT2		; Checksum
	BRA	CRLF

	;; Motorola S record
SHLS:	
	MOVE.B	#'S',D0
	BSR	con_out
	MOVE.B	#'1',D0
	BSR	con_out

	MOVE.B	D2,D0
	ADDQ.B	#2+1,D0		; DataLength + 2(Addr) + 1(Sum)
	MOVE.B	D0,D3		; Checksum
	BSR	HEXOUT2		; Length

	MOVE.L	A1,D0
	LSR.L	#8,D0
	ADD.B	D0,D3		; Checksum
	BSR	HEXOUT2		; Address H

	MOVE.L	A1,D0
	ADD.B	D0,D3		; Checksum
	BSR	HEXOUT2		; Address L

	SUBQ	#1,D2
SHLS0:
	MOVE.B	(A1)+,D0
	ADD.B	D0,D3		; Checksum
	BSR	HEXOUT2		; Data

	DBF	D2,SHLS0

	MOVE.B	D3,D0
	NOT.B	D0
	BSR	HEXOUT2
	BRA	CRLF

;;;
;;; Register
;;;
	IF USE_REGCMD

REG:
	ADDQ	#1,A0
	BSR	SKIPSP
	MOVE.B	(A0),D0
	BSR	UPPER
	TST.B	D0
	BNE	RG0
	BSR	RDUMP
	BRA	WSTART
RG0:
	LEA	RNTAB,A1
RG1:
	CMP.B	(A1),D0
	BEQ	RG2		; Character match
	TST.B	1(A1)
	BEQ	RGE
	ADD.L	#10,A1
	BRA	RG1
RG2:
	CMP.B	#$0F,1(A1)
	BNE	RG3
	;; Next table
	MOVE.L	2(A1),A1
	ADDQ	#1,A0
	MOVE.B	(A0),D0
	BSR	UPPER
	BRA	RG1
RG3:	
	MOVE.B	1(A1),D3
	BEQ	RGE		; Found end mark
	BPL	RG30
	;; Check MC68010
	TST.B	PSPEC
	BEQ	RGE
RG30:
	MOVE.L	6(A1),A0
	BSR	STROUT
	MOVE.B	#'=',D0
	BSR	con_out
	MOVE.L	2(A1),A2
	AND.B	#$07,D3
	CMP.B	#1,D3
	BNE	RG4
	;; 8 bit register
	MOVE.B	(A2),D0
	BSR	HEXOUT2
	BRA	RG6
RG4:
	CMP.B	#2,D3
	BNE	RG5
	;; 16 bit register
	MOVE	(A2),D0
	BSR	HEXOUT4
	BRA	RG6
RG5:
	;; 32 bit register
	MOVE.L	(A2),D0
	BSR	HEXOUT8
RG6:
	MOVE.B	#' ',D0
	BSR	con_out
	BSR	GETLIN
	LEA	INBUF,A0
	BSR	SKIPSP
	BSR	RDHEX
	TST	D2
	BEQ	RGR
	CMP.B	#1,D3
	BNE	RG7
	;; 8 bit register
	MOVE.B	D1,(A2)
	BRA	RG9
RG7:
	CMP.B	#2,D3
	BNE	RG8
	;; 16 bit register
	MOVE	D1,(A2)
	BRA	RG9
RG8:
	;; 32 bit register
	MOVE.L	D1,(A2)
RG9:
RGR:
	BRA	WSTART
RGE:
	BRA	ERR
	
RDUMP:
	LEA	RDTAB,A1
RD0:
	MOVE	(A1)+,D1	; Flag
	BEQ	CRLF		; Found END mark => CR,LF and return
	BPL	RD00
	TST.B	PSPEC
	BEQ	CRLF		; 
RD00:	
	MOVE.L	(A1)+,A0	; String address
	BSR	STROUT
	MOVE.L	(A1)+,A0	; Register save area
	AND	#$0003,D1
	CMP	#1,D1
	BNE	RD1
	;; BYTE size
	MOVE.B	(A0),D0
	BSR	HEXOUT2
	BRA	RD0
RD1:
	CMP	#2,D1
	BNE	RD2
	;; WORD size
	MOVE	(A0),D0
	BSR	HEXOUT4
	BRA	RD0
RD2:
	;; LONG size
	MOVE.L	(A0),D0
	BSR	HEXOUT8
	BRA	RD0

	ENDIF

;;;
;;; Other support routines
;;;

STROUT:
	MOVE.B	(A0)+,D0
	TST.B	D0
	BEQ	STROE
	BSR	con_out
	BRA	STROUT
STROE:
	RTS

HEXOUT8:
	MOVE.L	D0,-(A7)
	SWAP	D0
	BSR	HEXOUT4
	MOVE.L	(A7)+,D0
HEXOUT4:
	MOVE.L	D0,-(A7)
	ROR	#8,D0
	BSR	HEXOUT2
	MOVE.L	(A7)+,D0
HEXOUT2:
	MOVE.L	D0,-(A7)
	ROR.B	#4,D0
	BSR	HEXOUT1
	MOVE.L	(A7)+,D0
HEXOUT1:
	AND.B	#$0F,D0
	ADD.B	#'0',D0
	CMP.B	#'9'+1,D0
	BCS	con_out
	ADD	#'A'-'9'-1,D0
	BRA	con_out

HEXIN:
	CLR.B	D0
	BSR	HI0
	LSL.B	#4,D0
HI0:
	MOVE	D0,-(A7)
	BSR	con_in
	BSR	UPPER
	CMP.B	#'0',D0
	BCS	HIR
	CMP.B	#'9'+1,D0
	BCS	HI1
	CMP.B	#'A',D0
	BCS	HIR
	CMP.B	#'F'+1,D0
	BCC	HIR
	SUB.B	#'A'-'9'-1,D0
HI1:
	SUB.B	#'0',D0
	OR	(A7),D0
HIR:
	ADDQ	#2,A7
	RTS

CRLF:
	MOVE.B	#CR,D0
	BSR	con_out
	MOVE.B	#LF,D0
	BRA	con_out

GETLIN:
	LEA	INBUF,A0
	CLR.B	D1
GL0:
	BSR	con_in
	CMP.B	#CR,D0
	BEQ	GLE
	CMP.B	#LF,D0
	BEQ	GLE
	CMP.B	#BS,D0
	BEQ	GLB
	CMP.B	#DEL,D0
	BEQ	GLB
	CMP.B	#' ',D0
	BCS	GL0
	CMP.B	#$80,D0
	BCC	GL0
	CMP.B	#BUFLEN-1,D1
	BCC	GL0		; Too long
	ADDQ.B	#1,D1
	MOVE.B	D0,(A0)+
	BSR	con_out
	BRA	GL0
GLB:
	TST.B	D1
	BEQ	GL0
	SUBQ.L	#1,A0
	SUBQ.B	#1,D1
	MOVE.B	#BS,D0
	BSR	con_out
	MOVE.B	#' ',D0
	BSR	con_out
	MOVE.B	#BS,D0
	BSR	con_out
	BRA	GL0
GLE:
	BSR	CRLF
	MOVE.B	#$00,(A0)
	RTS

SKIPSP:
	CMP.B	#' ',(A0)+
	BEQ	SKIPSP
	SUBQ.L	#1,A0
	RTS

UPPER:
	CMP.B	#'a',D0
	BCS	UPR
	CMP.B	#'z'+1,D0
	BCC	UPR
	ADD.B	#'A'-'a',D0
UPR:
	RTS

RDHEX:
	CLR	D2		; Count
	CLR.L	D1		; Value
RH0:
	MOVE.B	(A0),D0
	BSR	UPPER
	CMP.B	#'0',D0
	BCS	RHE
	CMP.B	#'9'+1,D0
	BCS	RH1
	CMP.B	#'A',D0
	BCS	RHE
	CMP.B	#'F'+1,D0
	BCC	RHE
	SUB.B	#'A'-'9'-1,D0
RH1:
	SUB.B	#'0',D0
	LSL.L	#4,D1
	OR.B	D0,D1
	ADDQ	#1,A0
	ADDQ	#1,D2
	BRA	RH0
RHE:
	RTS

;;;
;;; Exception Handler
;;;

;
; timer interrupt handler
;contmp_buf	ds.b	con_size	; tmp string buffer

IRQ5_H:
	movem.l	d0-d3/a0-a1, -(a7)	;push d0,d1,a0,a1
	cmp.b	#$80, crd_cnt
	beq	exit_cin	; buffer full, then ignore key data

	move.l	#contmp_buf, STR_addr	; save temp buffer address

	; change change big endian to little endian
	lea	STR_addr, a0
	move.b	(a0), d0		;hh
	move.b	1(a0), d1		;hl
	move.b	2(a0), d2		;lh
	move.b	3(a0), d3		;ll
	move.b	d3,(a0)
	move.b	d2,1(a0)
	move.b	d1,2(a0)
	move.b	d0,3(a0)

	move.b	#$80, d0
	sub.b	crd_cnt,d0		; d0 = #$80 - crd_cnt
	move.b	d0, UNI_CHR		; set read buffer size
	move.b	#REQ_STRIN, UREQ_COM	; set string input request
	move.b	PIC_REQ, d0		; request STRIN to PIC. Memory $80000 read
wa_pic:
	move.b	UREQ_COM, d0
	bne	wa_pic

	move.b	UNI_CHR, d0		; get string count
	beq	exit_cin		; exit, if no data

	lea	crd_buf, a0		; a0 = crd_buf
	lea	contmp_buf, a1		; a1 = contmp_buf
	clr.l	d1
	move.b	crd_wp, d1		; d1 = crd_wp

mv_str:
	move.b	(a1), 0(a0,d1)	; crd_buf[d1] <- (a1)++
	addq	#1, a1
	addq.b	#1, d1			; crd_wp++
	andi.b	#$7f, d1
	addq.b	#1, crd_cnt		; crd_cnt++
	subq.b	#1, d0			; decriment string count
	bne	mv_str
	move.b	d1, crd_wp		; update write point

exit_cin:
	moveq	#1, d0
	bsr	clr_int			; clear interrupt request
	movem.l	(a7)+, d0-d3/a0-a1	 ;pop a1,a0,d1,d0

	;; Dummy
DUMMY_H:
	RTE
;
; NMI interrupt
;
NMI_H:
	LEA	NMI_MSG,A0
	BSR	STROUT
	moveq	#0, d0
	bsr	clr_int			; clear interrupt request
	bra	WSTART

NMI_MSG:	DC.B	CR,LF,"NMI Interrupt!!",CR,LF,$00

clr_int:
	move.b	d0, UNI_CHR		; set interrupt source(0: NMI 1:IRQ5)
	move.b	#REQ_CLR_IRQ, UREQ_COM	; set clear interrupt request
	move.b	PIC_REQ, d0		; request conin to PIC. Memory $80000 read
w_pic:
	move.b	UREQ_COM, d0
	bne	w_pic
	rts

	;; 02 Bus Error
BUSERR_H:
	MOVE.L	#BUSERR_M,EXMSG
	CLR	EXGRP		; Exception Group 0

	BRA	COMM_H

	;; 03 Address Error
ADDERR_H:
	MOVE.L	#ADDERR_M,EXMSG
	CLR	EXGRP		; Exception Group 0

	BRA	COMM_H

	;; 04 Illegal Instruction
ILLINS_H:
	;; Check IDENT
	IF USE_IDENT

	CMP.L	#ID0,2(A7)	; Check PC on system stack
	BNE	ILLINS0		; PC is not IDENT routine

	;; MOVEC VBR,D0 caused error ==> MC68000 or MC68008
	ADDQ	#6,A7		; Drop stack frame (MC68000 format)
	CLR.B	PSPEC
	BRA	ID9

ILLINS0:
	CMP.L	#ID1,2(A7)
	BNE	ILLINS1

	;; CALLM caused error ==> MC68010 or MC68030
	ADDQ	#8,A7		; Drop stack frame (MC68010- format)
	BRA	ID2

ILLINS1:
	CMP.L	#ID3,2(A7)
	BNE	ILLINS2

	;; MOVEC CACR,D0 caused error ==> MC68010
	ADDQ	#8,A7		; Drop stack frame (MC68010- format)
	LEA	IM010,A0
	MOVE.B	#1,PSPEC
	BRA	ID9

ILLINS2:	
ILLINS9:
	ENDIF

	IF USE_REGCMD
	MOVEM.L	D0-D7/A0-A6,REGD0
	ELSE
	MOVEM.L	D0-D3,REGD0
	MOVEM.L	A0-A3,REGA0
	ENDIF

	MOVE.L	#ILLINS_M,EXMSG
	MOVE	#1,EXGRP	; Exception Group 1

	;; Check BREAK
	MOVE.L	2(A7),A0	; Get PC
	MOVE	(A0),D0		; Read OP-code
	CMP	#$4AFC,D0
	BEQ	BREAK
	AND	#$FFF8,D0
	CMP	#$4848,D0
	BNE	COMM_H0
BREAK:
	MOVE.L	#BREAK_M,EXMSG
	MOVE	#$0101,EXGRP	; BREAK
	BRA	COMM_H0

	;; 05 Zero Divide
ZERDIV_H:
	MOVE.L	#ZERDIV_M,EXMSG
	MOVE	#2,EXGRP	; Exception Group 2

	BRA	COMM_H

	;; 06 CHK Instruction
CHK_H:
	MOVE.L	#CHK_M,EXMSG
	MOVE	#2,EXGRP	; Exception Group 2

	BRA	COMM_H

	;; 07 TRAPV Instruction
TRAPV_H:
	MOVE.L	#TRAPV_M,EXMSG
	MOVE	#2,EXGRP	; Exception Group 2

	BRA	COMM_H

	;; 08 Privilege Violation
PRIV_H:
	MOVE.L	#PRIV_M,EXMSG
	MOVE	#1,EXGRP	; Exception Group 1

	BRA	COMM_H

	;; 09 Trace
TRACE_H:
	MOVE.L	#TRACE_M,EXMSG
	MOVE	#1,EXGRP	; Exception Group 1

	BRA	COMM_H

	;; 10 Line 1010 Emulator
L1010_H:
	MOVE.L	#L1010_M,EXMSG
	MOVE	#1,EXGRP	; Exception Group 1

	BRA	COMM_H

	;; 11 Line 1111 Emulator
L1111_H:
	MOVE.L	#L1111_M,EXMSG
	MOVE	#1,EXGRP	; Exception Group 1

	BRA	COMM_H

	;; 14 Format Error
FORMAT_H:
	MOVE.L	#FORMAT_M,EXMSG
	MOVE	#1,EXGRP	; Exception Group 1

	BRA	COMM_H

	;; 32 TRAP #0
TRAP0_H:
	MOVE.L	#TRAP0_M,EXMSG
	MOVE	#2,EXGRP	; Exception Group 2

	BRA	COMM_H

	;; 33 TRAP #1
TRAP1_H:
	MOVE.L	#TRAP1_M,EXMSG
	MOVE	#2,EXGRP	; Exception Group 2

	BRA	COMM_H

	;; 34 TRAP #2
TRAP2_H:
	MOVE.L	#TRAP2_M,EXMSG
	MOVE	#2,EXGRP	; Exception Group 2

	BRA	COMM_H

	;; 35 TRAP #3
TRAP3_H:
	MOVE.L	#TRAP3_M,EXMSG
	MOVE	#2,EXGRP	; Exception Group 2

	BRA	COMM_H

	;; 36 TRAP #4
TRAP4_H:
	MOVE.L	#TRAP4_M,EXMSG
	MOVE	#2,EXGRP	; Exception Group 2

	BRA	COMM_H

	;; 37 TRAP #5
TRAP5_H:
	MOVE.L	#TRAP5_M,EXMSG
	MOVE	#2,EXGRP	; Exception Group 2

	BRA	COMM_H

	;; 38 TRAP #6
TRAP6_H:
	MOVE.L	#TRAP6_M,EXMSG
	MOVE	#2,EXGRP	; Exception Group 2

	BRA	COMM_H

	;; 39 TRAP #7
TRAP7_H:
	MOVE.L	#TRAP7_M,EXMSG
	MOVE	#2,EXGRP	; Exception Group 2

	BRA	COMM_H

	;; 40 TRAP #8
TRAP8_H:
	MOVE.L	#TRAP8_M,EXMSG
	MOVE	#2,EXGRP	; Exception Group 2

	BRA	COMM_H

	;; 41 TRAP #9
TRAP9_H:
	MOVE.L	#TRAP9_M,EXMSG
	MOVE	#2,EXGRP	; Exception Group 2

	BRA	COMM_H

	;; 42 TRAP #10
TRAP10_H:
	MOVE.L	#TRAP10_M,EXMSG
	MOVE	#2,EXGRP	; Exception Group 2

	BRA	COMM_H

	;; 43 TRAP #11
TRAP11_H:
	MOVE.L	#TRAP11_M,EXMSG
	MOVE	#2,EXGRP	; Exception Group 2

	BRA	COMM_H

	;; 44 TRAP #12
TRAP12_H:
	MOVE.L	#TRAP12_M,EXMSG
	MOVE	#2,EXGRP	; Exception Group 2

	BRA	COMM_H

	;; 45 TRAP #13
TRAP13_H:
	MOVE.L	#TRAP13_M,EXMSG
	MOVE	#2,EXGRP	; Exception Group 2

	BRA	COMM_H

	;; 46 TRAP #14
TRAP14_H:
	MOVE.L	#TRAP14_M,EXMSG
	MOVE	#2,EXGRP	; Exception Group 2

	BRA	COMM_H

	;; 47 TRAP #15
TRAP15_H:
	MOVE.L	#TRAP15_M,EXMSG
	MOVE	#2,EXGRP	; Exception Group 2

	BRA	COMM_H

	;; 
	;; Common handler
	;; 
COMM_H:
	;; Save registers
	IF USE_REGCMD
	MOVEM.L	D0-D7/A0-A6,REGD0
	ELSE
	MOVEM.L	D0-D3,REGD0
	MOVEM.L	A0-A3,REGA0
	ENDIF

COMM_H0:
	
	IF USE_REGCMD

	TST	EXGRP
	BNE	CH0		; not Group 0
	TST.B	PSPEC
	BNE	CH0		; not MC68000/8

	;; MC68000/8 : Group 0 (Bus/address error)
	LEA	GR0BUF,A0
	MOVE	(A7)+,(A0)+
	MOVE.L	(A7)+,(A0)+	; Access address
	MOVE	(A7)+,(A0)+	; Instruction register
CH0:
	;; Common
	MOVE	(A7)+,REGSR
	MOVE.L	(A7)+,REGPC

	MOVE	USP,A0
	MOVE.L	A0,REGA7
	
	TST.B	PSPEC
	BEQ	CH2

	;; MC68010
	SAVE
	CPU	68010
	MOVEC	VBR,D0
	MOVE.L	D0,REGVBR
	MOVEC	SFC,D0
	MOVE.B	D0,REGSFC
	MOVEC	SFC,D0
	MOVE.B	D0,REGDFC
	RESTORE

	MOVE	(A7)+,D2	; Format / Vector offset
	MOVE	D2,REGFV
	ROL.W	#4,D2
	AND	#$000F,D2
	LEA	GR0BUF,A0
	LEA	FMTLEN,A1
	CLR	D3
	MOVE.B	0(A1,D2.W),D3
	SUBQ	#4,D3		; 4 words already POPed
	BLS	CH2		; No more to POP, or unknown format
	SUBQ	#1,D3
CH1:
	MOVE	(A7)+,(A0)+
	DBF	D3,CH1
	
CH2:
	MOVE.L	A7,REGSSP

	ELSE
	;; USE_REGCMD == 0

	TST.B	PSPEC
	BNE	CH1

	;; MC68000/8
	TST	D2
	BNE	CH0

	;; Group 0
	ADD.L	#7*2,A7
	BRA	CH3

CH0:
	;; Group 1-3
	ADD.L	#3*2,A7
	BRA	CH3
	
CH1:
	;; MC68010 and above
	MOVE	6(A7),D2	; Get format word
	ROL	#4,D2
	AND	#$000F,D2
	LEA	FMTLEN,A1
	CLR	D3
	MOVE.B	0(A1,D2.W),D3
	ASL	#1,D3
	ADD	D3,A7

CH3:	
	ENDIF

	MOVE.L	EXMSG,A0
	BSR	STROUT
	BSR	CRLF
	IF USE_REGCMD
	TST	EXGRP
	BNE	CH4
	BSR	G0DUMP
CH4:	
	BSR	RDUMP
	ELSE
	IFDEF DEBUG
	MOVE.L	A7,D0
	BSR	HEXOUT8
	ENDIF
	BSR	CRLF
	ENDIF

	BRA	WSTART

	IF USE_REGCMD
;;; DUMP group 0 (Address/Bus Error)
G0DUMP:
	TST.B	PSPEC
	BNE	G0D1

	;; MC68000/MC68008
	IFDEF DEBUG
	MOVE	GR0BUF,D0
	BSR	HEXOUT4
	MOVE.B	#' ',D0
	BSR	con_out
	MOVE.L	GR0BUF+2,D0
	BSR	HEXOUT8		; Access address
	MOVE.B	#' ',D0
	BSR	con_out
	MOVE	GR0BUF+6,D0
	BSR	HEXOUT4		; Instruction register
	BSR	CRLF
	ENDIF

	;; Function Code
	MOVE	GR0BUF,D0
	AND	#$0007,D0
	LSL	#2,D0
	LEA	FCTAB,A0
	MOVE.L	0(A0,D3.W),A0
	BSR	STROUT

	;; Read / Write
	MOVE	GR0BUF,D0
	AND	#$0010,D0
	BNE	G0D00
	LEA	G0WR,A0
	BRA	G0D01
G0D00:
	LEA	G0RD,A0
G0D01:
	BSR	STROUT

	;; Address
	MOVE.L	GR0BUF+2,D0
	BSR	HEXOUT8		; Access address

	;; Instruction Register
	LEA	G0INS0,A0
	BSR	STROUT
	MOVE	GR0BUF+6,D0
	BSR	HEXOUT4		; Instruction register
	MOVE.B	#')',D0
	BSR	con_out

	BRA	CRLF

G0D1:
	IF USE_SFDECODE
	MOVE	REGFV,D3
	ROL	#4,D3
	AND	#$000F,D3
	CMP	#$08,D3
	BNE	G0D2		; Not MC68010

	;; MC68010
	IFDEF DEBUG
	MOVE	GR0BUF,D0	; Special Status Word
	BSR	HEXOUT4
	MOVE	#' ',D0
	BSR	con_out
	MOVE.L	GR0BUF+2,D0	; Fault Address
	BSR	HEXOUT8
	MOVE	#' ',D0
	BSR	con_out
	MOVE	GR0BUF+8,D0
	BSR	HEXOUT4
	BSR	CRLF
	ENDIF

	;; Function Code
	MOVE	GR0BUF,D0
	AND	#$0007,D0
	LSL	#2,D0
	LEA	FCTAB2,A0
	MOVE.L	0(A0,D0),A0
	BSR	STROUT
	LEA	G0SPC,A0
	BSR	STROUT

	;; Read / Write
	MOVE	GR0BUF,D0
	BTST	#8,D0
	BNE	G0D10
	LEA	G0WR,A0
	BRA	G0D11
G0D10:
	LEA	G0RD,A0
G0D11:
	BSR	STROUT

	;; BYTE / WORD
	MOVE	GR0BUF,D0
	BTST	#9,D0
	BEQ	G0D12
	LEA	G0BYTE,A0
	BRA	G0D13
G0D12:
	LEA	G0WORD,A0
G0D13:
	BSR	STROUT

	;; Write Data
	LEA	G0FROM,A0
	MOVE	GR0BUF,D0
	BTST	#8,D0
	BNE	G0D17		; if READ
	BTST	#9,D0
	BEQ	G0D15		; if WORD
	MOVE	GR0BUF+8,D1
	BTST	#10,D0
	BEQ	G0D14		; if not HB
	LSR	#8,D1
G0D14:
	MOVE.B	D1,D0
	BSR	HEXOUT2
	BRA	G0D16
G0D15:
	MOVE	GR0BUF+8,D0
	BSR	HEXOUT4
G0D16:
	LEA	G0TO,A0
G0D17:	
	BSR	STROUT

	;; Address
	MOVE.L	GR0BUF+2,D0
	BSR	HEXOUT8		; Access address

	;; Instruction Fetch
	MOVE	GR0BUF,D0
	BTST	#13,D0
	BEQ	G0D18
	LEA	G0IF,A0
	BSR	STROUT
G0D18:
	;; Read-Modify-Write
	MOVE	GR0BUF,D0
	BTST	#11,D0
	BEQ	G0D19
	LEA	G0RMW,A0
	BSR	STROUT
G0D19:
	BRA	CRLF

G0D2:
	CMP	#$0A,D3		; MC68020/MC68030 Short Bus Fault Stack Frame
	BEQ	G0D20
	CMP	#$0B,D3		; MC68020/MC68030 Long Bus Fault Stack Frame
	BNE	G0D3
G0D20:
	;; MC68020 / MC68030


G0D3:
	ENDIF			; USE_SFDECODE

G0D9:
	;; Unsupported Stack Frame
	MOVE	REGSR,D0
	BSR	HEXOUT4
	MOVE.B	#' ',D0
	BSR	con_out

	MOVE	REGPC,D0
	BSR	HEXOUT4
	MOVE.B	#' ',D0
	BSR	con_out

	MOVE	REGPC+2,D0
	BSR	HEXOUT4
	MOVE.B	#' ',D0
	BSR	con_out

	MOVE	REGFV,D0
	BSR	HEXOUT4
	MOVE.B	#' ',D0
	BSR	con_out

	CLR	D2
	LEA	FMTLEN,A0
	MOVE	REGFV,D3
	ROL	#4,D3
	AND	#$000F,D3
	MOVE.B	0(A0,D3),D2
	MOVEQ	#4,D3		; Counter.  4 words already printed
	LEA	GR0BUF,A0

G0D90:
	MOVE	(A0)+,D0
	BSR	HEXOUT4
	ADDQ	#1,D3
	CMP	D3,D2
	BLS	G0D92
	MOVE	#$000F,D0
	AND	D3,D0
	BNE	G0D91
	BSR	CRLF
	BRA	G0D90
G0D91:
	MOVE.B	#' ',D0
	BSR	con_out
	BRA	G0D90
G0D92:	
	BRA	CRLF

	ENDIF

	IF USE_IDENT

	SAVE
	CPU	68020
DMYRTM:
	DC.W	$F000		; A7
	RTM	A7
	RESTORE

	ENDIF

;;;
;;; Data area
;;; 
	
OPNMSG:	DC.B	CR,LF,"Universal Monitor 68000",CR,LF,$00

PROMPT:	DC.B	"] ",$00

IHEMSG:	DC.B	"Error ihex",CR,LF,$00
SHEMSG:	DC.B	"Error srec",CR,LF,$00
ERRMSG:	DC.B	"Error",CR,LF,$00

DSEP0:	DC.B	" :",$00
DSEP1:	DC.B	" : ",$00
IHEXER:	DC.B	":00000001FF",CR,LF,$00
SRECER: DC.B	"S9030000FC",CR,LF,$00

	IF USE_IDENT

IM000:	DC.B	"MC68000",CR,LF,$00
IM010:	DC.B	"MC68010",CR,LF,$00
IM020:	DC.B	"MC68020",CR,LF,$00
IM030:	DC.B	"MC68030",CR,LF,$00

	;; Module Descriptor for CALLM
	ALIGN	4
MDESC:
	DC.L	$00000000	; Opt=000, Type=$00, AL=$00
	DC.L	DMYRTM		; Module Entry Word Pointer
	DC.L	$00000000	; Module Data Area Pointer
	DC.L	$00000000
	
	ENDIF

BUSERR_M:
	DC.B	"Bus Error",$00
ADDERR_M:
	DC.B	"Address Error",$00
ILLINS_M:
	DC.B	"Illegal Instruction",$00
ZERDIV_M:
	DC.B	"Zero Divide",$00
CHK_M:
	DC.B	"CHK Instruction",$00
TRAPV_M:
	DC.B	"TRAPV Instruction",$00
PRIV_M:
	DC.B	"Privilege Violation",$00
TRACE_M:
	DC.B	"Trace",$00
L1010_M:
	DC.B	"Line 1010 Emulator",$00
L1111_M:
	DC.B	"Line 1111 Emulator",$00
FORMAT_M:
	DC.B	"Format Error",$00
TRAP0_M:
	DC.B	"TRAP #0",$00
TRAP1_M:
	DC.B	"TRAP #1",$00
TRAP2_M:
	DC.B	"TRAP #2",$00
TRAP3_M:
	DC.B	"TRAP #3",$00
TRAP4_M:
	DC.B	"TRAP #4",$00
TRAP5_M:
	DC.B	"TRAP #5",$00
TRAP6_M:
	DC.B	"TRAP #6",$00
TRAP7_M:
	DC.B	"TRAP #7",$00
TRAP8_M:
	DC.B	"TRAP #8",$00
TRAP9_M:
	DC.B	"TRAP #9",$00
TRAP10_M:
	DC.B	"TRAP #10",$00
TRAP11_M:
	DC.B	"TRAP #11",$00
TRAP12_M:
	DC.B	"TRAP #12",$00
TRAP13_M:
	DC.B	"TRAP #13",$00
TRAP14_M:
	DC.B	"TRAP #14",$00
TRAP15_M:
	DC.B	"TRAP #15",$00

BREAK_M:
	DC.B	"BREAK",$00


	IF USE_REGCMD

	ALIGN	2
RDTAB:	DC.W	$0003		; LONG
	DC.L	RDSD07, REGD0
	DC.W	$0003
	DC.L	RDSC,   REGD1
	DC.W	$0003
	DC.L	RDSC,   REGD2
	DC.W	$0003
	DC.L	RDSC,   REGD3
	DC.W	$0003
	DC.L	RDSCS,  REGD4
	DC.W	$0003
	DC.L	RDSC,   REGD5
	DC.W	$0003
	DC.L	RDSC,   REGD6
	DC.W	$0003
	DC.L	RDSC,   REGD7

	DC.W	$0003
	DC.L	RDSA07, REGA0
	DC.W	$0003
	DC.L	RDSC,   REGA1
	DC.W	$0003
	DC.L	RDSC,   REGA2
	DC.W	$0003
	DC.L	RDSC,   REGA3
	DC.W	$0003
	DC.L	RDSCS,  REGA4
	DC.W	$0003
	DC.L	RDSC,   REGA5
	DC.W	$0003
	DC.L	RDSC,   REGA6
	DC.W	$0003
	DC.L	RDSC,   REGA7

	DC.W	$0003
	DC.L	RDSPC,  REGPC
	DC.W	$0003
	DC.L	RDSSSP, REGSSP
	DC.W	$0002		; WORD
	DC.L	RDSSR,  REGSR

	DC.W	$8003		; LONG + (END flag for MC68000/8)
	DC.L	RDSVBR, REGVBR
	DC.W	$8001		; BYTE
	DC.L	RDSSFC, REGSFC
	DC.W	$8001		; BYTE
	DC.L	RDSDFC, REGDFC	
	
	DC.W	$0000		; END

RDSD07:	DC.B	"D0-D7=",$00
RDSA07:	DC.B	CR,LF,"A0-A7=",$00
RDSPC:	DC.B	CR,LF,"PC=",$00
RDSSSP:	DC.B	" SSP=",$00
RDSSR:	DC.B	" SR=",$00
RDSVBR:	DC.B	"  VBR=",$00
RDSSFC:	DC.B	" SFC=",$00
RDSDFC:	DC.B	" DFC=",$00
RDSC:	DC.B	",",$00
RDSCS:	DC.B	", ",$00

	ALIGN	2
RNTAB:
	DC.B	'A',$0F		; "A?"
	DC.L	RNTABA,0
	DC.B	'C',$0F		; "C?"
	DC.L	RNTABC,0
	DC.B	'D',$0F		; "D?"
	DC.L	RNTABD,0
	DC.B	'P',$0F		; "P?"
	DC.L	RNTABP,0
	DC.B	'S',$0F		; "S?"
	DC.L	RNTABS,0
	DC.B	'V',$0F		; "V?"
	DC.L	RNTABV,0

	DC.B	$00,$00		; End mark
	DC.L	0,0

RNTABA:
	DC.B	'0',3		; "A0"
	DC.L	REGA0, RNA0
	DC.B	'1',3		; "A1"
	DC.L	REGA1, RNA1
	DC.B	'2',3		; "A2"
	DC.L	REGA2, RNA2
	DC.B	'3',3		; "A3"
	DC.L	REGA3, RNA3
	DC.B	'4',3		; "A4"
	DC.L	REGA4, RNA4
	DC.B	'5',3		; "A5"
	DC.L	REGA5, RNA5
	DC.B	'6',3		; "A6"
	DC.L	REGA6, RNA6
	DC.B	'7',3		; "A7"
	DC.L	REGA7, RNA7

	DC.B	$00,$00		; End mark
	DC.L	0,0

RNTABC:
	DC.B	'C', $0F	; "CC"
	DC.L	RNTABCC, 0
	
	DC.B	$00,$00		; End mark
	DC.L	0,0

RNTABD:
	DC.B	'0',3		; "D0"
	DC.L	REGD0, RND0
	DC.B	'1',3		; "D1"
	DC.L	REGD1, RND1
	DC.B	'2',3		; "D2"
	DC.L	REGD2, RND2
	DC.B	'3',3		; "D3"
	DC.L	REGD3, RND3
	DC.B	'4',3		; "D4"
	DC.L	REGD4, RND4
	DC.B	'5',3		; "D5"
	DC.L	REGD5, RND5
	DC.B	'6',3		; "D6"
	DC.L	REGD6, RND6
	DC.B	'7',3		; "D7"
	DC.L	REGD7, RND7
	DC.B	'F', $0F	; "DF?"
	DC.L	RNTABDF, 0

	DC.B	$00,$00		; End mark
	DC.L	0,0

RNTABP:
	DC.B	'C',3		; "PC"
	DC.L	REGPC, RNPC

	DC.B	$00,$00		; End mark
	DC.L	0,0

RNTABS:
	DC.B	'F', $0F	; "SF?"
	DC.L	RNTABSF, 0
	DC.B	'R', 2		; "SR"
	DC.L	REGSR, RNSR
	DC.B	'S', $0F	; "SS?"
	DC.L	RNTABSS, 0

	DC.B	$00,$00		; End mark
	DC.L	0,0

RNTABV:
	DC.B	'B', $0F	; "VB?"
	DC.L	RNTABVB, 0

	DC.B	$00,$00		; End mark
	DC.L	0,0

RNTABCC:
	DC.B	'R', 1		; "CCR"
	DC.L	REGSR+1, RNCCR
	
	DC.B	$00,$00		; End mark
	DC.L	0,0

RNTABDF:
	DC.B	'C', $81	; "DFC"
	DC.L	REGDFC, RNDFC
	
	DC.B	$00,$00		; End mark
	DC.L	0,0

RNTABSF:
	DC.B	'C', $81	; "SFC"
	DC.L	REGSFC, RNSFC
	
	DC.B	$00,$00		; End mark
	DC.L	0,0

RNTABSS:
	DC.B	'P', 3		; "SSP"
	DC.L	REGSSP, RNSSP
	
	DC.B	$00,$00		; End mark
	DC.L	0,0

RNTABVB:
	DC.B	'R', $83	; "VBR"
	DC.L	REGVBR, RNVBR
	
	DC.B	$00,$00		; End mark
	DC.L	0,0

RNA0:	DC.B	"A0",$00
RNA1:	DC.B	"A1",$00
RNA2:	DC.B	"A2",$00
RNA3:	DC.B	"A3",$00
RNA4:	DC.B	"A4",$00
RNA5:	DC.B	"A5",$00
RNA6:	DC.B	"A6",$00
RNA7:	DC.B	"A7",$00
RNCCR:	DC.B	"CCR",$00
RND0:	DC.B	"D0",$00
RND1:	DC.B	"D1",$00
RND2:	DC.B	"D2",$00
RND3:	DC.B	"D3",$00
RND4:	DC.B	"D4",$00
RND5:	DC.B	"D5",$00
RND6:	DC.B	"D6",$00
RND7:	DC.B	"D7",$00
RNDFC:	DC.B	"DFC",$00
RNPC:	DC.B	"PC",$00
RNSFC:	DC.B	"SFC",$00
RNSR:	DC.B	"SR",$00
RNSSP:	DC.B	"SSP",$00
RNVBR:	DC.B	"VBR",$00

FCTAB:	DC.L	FCN0,FCN1,FCN2,FCN3
	DC.L	FCN4,FCN5,FCN6,FCN7
FCTAB2:	DC.L	FCN0,FCN1,FCN2,FCN3
	DC.L	FCN4,FCN5,FCN6,FCN7A
FCN0:	DC.B	"FC=0 ",$00
FCN1:	DC.B	"User Data ",$00
FCN2:	DC.B	"User Program ",$00
FCN3:	DC.B	"FC=3 ",$00
FCN4:	DC.B	"FC=4 ",$00
FCN5:	DC.B	"Supervisor Data ",$00
FCN6:	DC.B	"Supervisor Program ",$00
FCN7:	DC.B	"Interrupt Acknowledge ",$00
FCN7A:	DC.B	"CPU ",$00
G0WR:	DC.B	"Write ",$00
G0RD:	DC.B	"Read ",$00
G0INS0:	DC.B	"  (Inst=",$00
G0BYTE:	DC.B	"Byte ",$00
G0WORD:	DC.B	"Word ",$00
G0TO:	DC.B	" to ",$00
G0FROM:	DC.B	"from ",$00
G0SPC:	DC.B	"Space ",$00
G0IF:	DC.B	" (Instruction Fetch)",$00
G0RMW:	DC.B	" (Read Modify Write)",$00
	ENDIF

	;; Stack frame size (WORD) for each format
FMTLEN:
	DC.B	4		; 0000 (68010,68020,SCC68070)
	DC.B	4		; 0001 Throw Away (68020)
	DC.B	6		; 0010 (68020)
	DC.B	6		; 0011
	DC.B	8		; 0100
	DC.B	0		; 0101
	DC.B	0		; 0110
	DC.B	30		; 0111
	DC.B	29		; 1000 Bus Error, Address Error (68010)
	DC.B	10		; 1001 Coprocessor Midinstruction (68020)
	DC.B	16		; 1010 Short Bus Fault (68020,68030)
	DC.B	46		; 1011 Long Bus Fault (68020,68030)
	DC.B	12		; 1100 Bus Error (CPU32)
	DC.B	0		; 1101
	DC.B	0		; 1110
	DC.B	17		; 1111 (SCC68070)


	ALIGN	2

;	IF USE_DEV_6850
;	INCLUDE	"dev/dev_6850.asm"
;	ENDIF

;	IF USE_DEV_68681
;	INCLUDE	"dev/dev_68681.asm"
;	ENDIF

;	IF USE_DEV_68901
;	INCLUDE	"dev/dev_68901.asm"
;	ENDIF

;	IF USE_DEV_EMILY
;	INCLUDE	"dev/dev_emily.asm"
;	ENDIF

;;;
;;;	UART Console Driver
;;;

INIT:
	;; Initialize PIC command request table
	;; and clear console input buffer control variables
	LEA	SHAD_M,A0
	MOVE	#(req_e-SHAD_M)-1,D0
shad_0:
	CLR.B	(A0)+
	DBF	D0,shad_0
	RTS


con_st:
	move.b	crd_cnt,d0
	rts

; output d0 : conin character
con_in:
	tst.b	crd_cnt
	beq.s	con_in

	; disable interrupt
	move sr, -(a7)		; save status register
	move #$2700, sr		; disable interrupt

	movem.l	d1/a0, -(a7)	;push d1,a0

	lea	crd_buf, a0	; a0 = crd_buf
	clr.l	d1
	move.b	crd_rp, d1	; d1 = crd_rp
	move.b	0(a0,d1), d0	; d0 <- crd_buf[d1]

	addq.b	#1, d1		; crd_rp++
	andi.b	#$7f, d1
	move.b	d1, crd_rp

	subq.b	#1,crd_cnt

	movem.l	(a7)+, d1/a0	 ;pop a0,d1

	; enable interrupt
	move	(a7)+, sr
	rts

; input d0 : conout character
con_out:
	movem.l	d0/d1, -(a7)	;push d0,d1
	move.b	d0, d1
cout_1:
	move sr, -(a7)		; save status register
	move #$2700, sr		; disable interrupt

	bsr	CONOUT
	move	(a7)+, sr

	or.b	d0, d0
	beq.s	end_cout
	move.b	d1, d0
	bra	cout_1

end_cout:
	movem.l	(a7)+, d0/d1	;pop d1, d0
	rts

;----------------------------------------------------------------------------------
;	ORG	SHAD_M
;
;			   ; offset:
;UREQ_COM:	DS.B	1	; 0: monitor CONIN/CONOUT request command
;UNI_CHR:	DS.B	1	; 1: charcter (CONIN/CONOUT) or number of strings
;STR_addr	DS.L	1	; 2: string address
;--------------------------------------------------------------------------------
;CREQ_COM:	DS.B	1	; 6: PIC function CONIN/CONOUT request command
;CBI_CHR:	DS.B	1	; 7: charcter or return status
;disk_drive:	DS.B	1	; 8
;disk_track:	DS.B	1	; 9
;disk_sector:	DS.W	1	; A
;data_dma:	DS.L	1	; C
;req_e:

CONIN:
	move.b	#REQ_CONIN1, UREQ_COM	; set CONIB request

cin0:
	move.b	PIC_REQ, d0		; request conin to PIC. Memory $80000 read
cin1:
	move.b	UREQ_COM, d0
;	or.b	d0, d0
	bne	cin1
	
	; get character or status
	move.b	UNI_CHR, d0
	RTS

CONOUT:
	move.b	#REQ_CONOUT1, UREQ_COM	; set CONOUT request
	move.b	d0, UNI_CHR		; set output character
	bra	cin0

ROM_E:

;;;
;;; Work area
;;;


WORK_B	EQU	(ROM_E+16) & $fffffff0

	ORG	WORK_B

INBUF:	DS.B	BUFLEN		; Line input buffer
DSADDR:	DS.L	1		; DUMP start address
DEADDR:	DS.L	1
DSTATE:	DS.B	1
	ALIGN	2
GADDR:	DS.L	1
SADDR:	DS.L	1		; SET address
HEXMOD:	DS.B	1		; HEX file mode
RECTYP:	DS.B	1		; Record type
PSPEC:	DS.B	1		; Processor spec.

	ALIGN	2

EXMSG:	DS.L	1		; Exception message
EXGRP:	DS.W	1		; Exception Group

REG_B:
REGPC:	DS.L	1

REGD0:	DS.L	1
REGD1:	DS.L	1
REGD2:	DS.L	1
REGD3:	DS.L	1
	IF USE_REGCMD
REGD4:	DS.L	1
REGD5:	DS.L	1
REGD6:	DS.L	1
REGD7:	DS.L	1
	ENDIF

REGA0:	DS.L	1
REGA1:	DS.L	1
REGA2:	DS.L	1
REGA3:	DS.L	1
	IF USE_REGCMD
REGA4:	DS.L	1
REGA5:	DS.L	1
REGA6:	DS.L	1
REGA7:	DS.L	1		; USP

REGSSP:	DS.L	1
REGSR:	DS.W	1
REGVBR:	DS.L	1
REGSFC:	DS.B	1
REGDFC:	DS.B	1

GR0BUF:	DS.W	46-4		; Group 0 exception
REGFV:	DS.W	1		; Format / Vector offset
	ENDIF
REG_E:

STACK:	EQU	(REG_E+$200) & $ffffff00
USTACK:	EQU	(REG_E+$300) & $ffffff00

DAT_E	equ	USTACK

	END
